juicie-brucie/LEAP_HIP/KiCAD/README.md

# KiCad and LTspice
Well see my other note in the main read me

## KiCad
Schematic mostly done
### ToDo
- Level shifter?
- I need to add the flyback diode back in
- Get a footprint for the HX711 module
- finalize bom
- make the layout

### Issues
Flyback diode
- tired
