juicie-brucie/LEAP_HIP/KiCAD/LTspice_simulation_RevCDR/button_debounce_sim.pdf

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

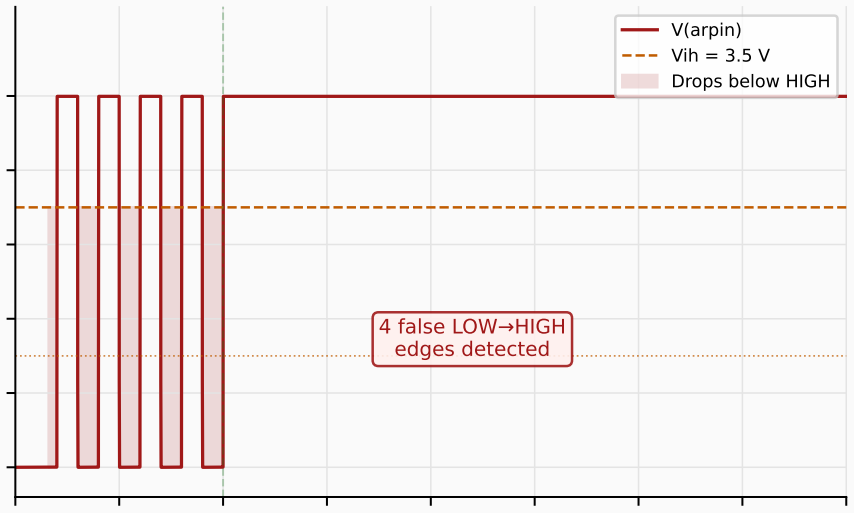
[picture p1: figure]
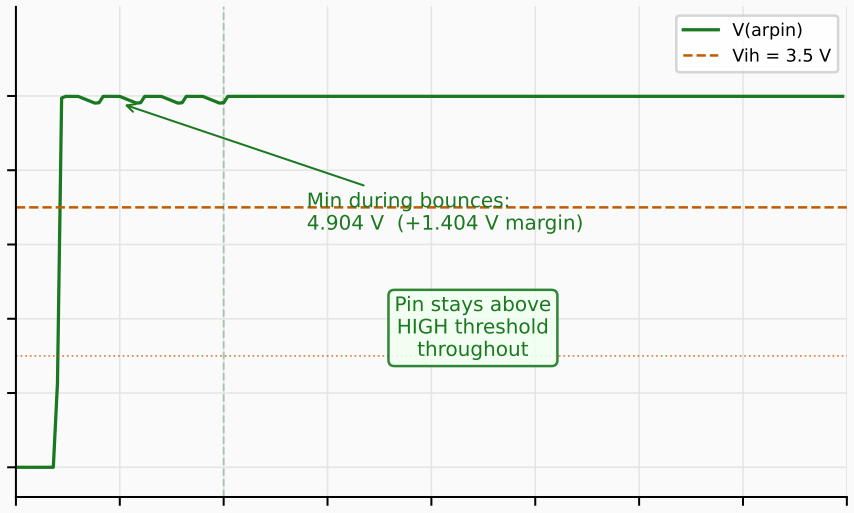
[picture p2: figure]

Parameter | Value | Notes
Filter cap (Rev B) | 100 nF | RC | = 1.0 ms | FAIL: pin drops below 3.5 V on every bounce
Filter cap (fix) | 2.2 µF | RC | = 22 ms | PASS: pin drops only 0.11 V during 0.5 ms bounce
Pulldown resistor | 10 k | Unchanged | sets | with cap; limits current draw
Discharge | (100 nF) | 1.0 ms | 10 k × 100 nF | bounce hold above 3.5 V = only 0.36 | ms
Discharge | (2.2 µF) | 22 ms | 10 k × 2.2 µF | bounce hold above 3.5 V >> 20 ms
Typical bounce duration | 1 | 20 ms | Tactile switches | must exceed worst-case bounce
Voltage drop / bounce | 0.11 V | 2.2 µF: 5 × (1 | e^( 0.5ms/22ms)) | pin stays at 4.89 | V
ATmega328 Vih | 3.5 V | 0.7 × Vcc | Schmitt trigger HIGH threshold at 5 V supply
ATmega328 Vil | 1.5 V | 0.3 × Vcc | Schmitt trigger LOW threshold
Glitches (100 nF) | 4 edges | Arduino sees 4 false button presses per physical press
Glitches (2.2 µF) | 0 edges | No threshold crossing during bounces
Firmware debounce | Required | Read | wait 20 ms | re-read; accept only if still HIGH

NOTE: button_debounce.cir has been updated to use a voltage-controlled switch model. Re-run it in LTspice GUI to get full SPICE confirmation of the 2.2 µF result. The 2.2 µF curve above is computed analytically from the correct RC model.

## Button Debounce Parameters & Fix

BURPG HIP Rev B · LTspice 26.0 · 2026-09-29
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
