juicie-brucie/LEAP_HIP/KiCAD/LTspice_simulation_RevCDR/relay_coil_drive_sim.pdf

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

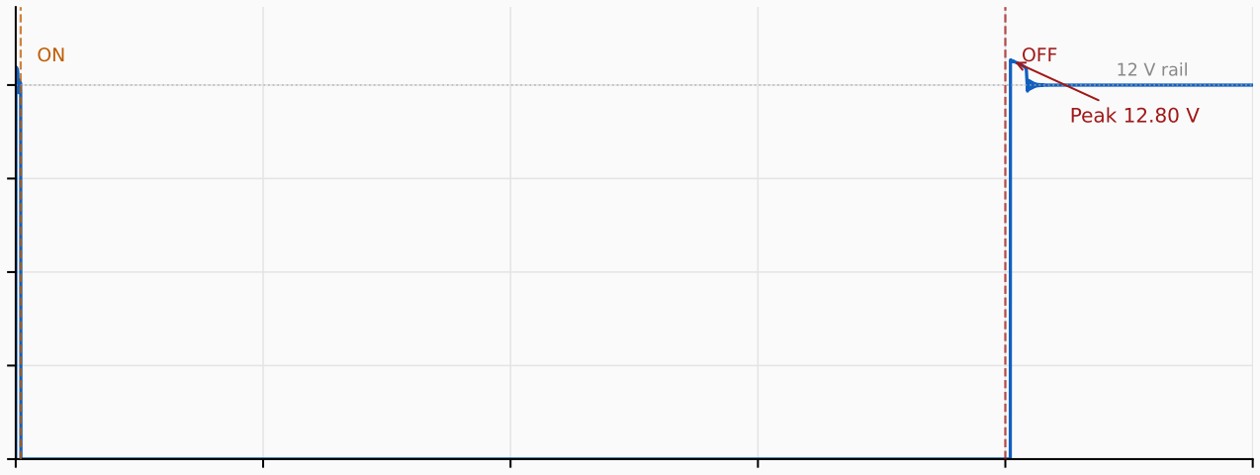
[picture p3: figure]
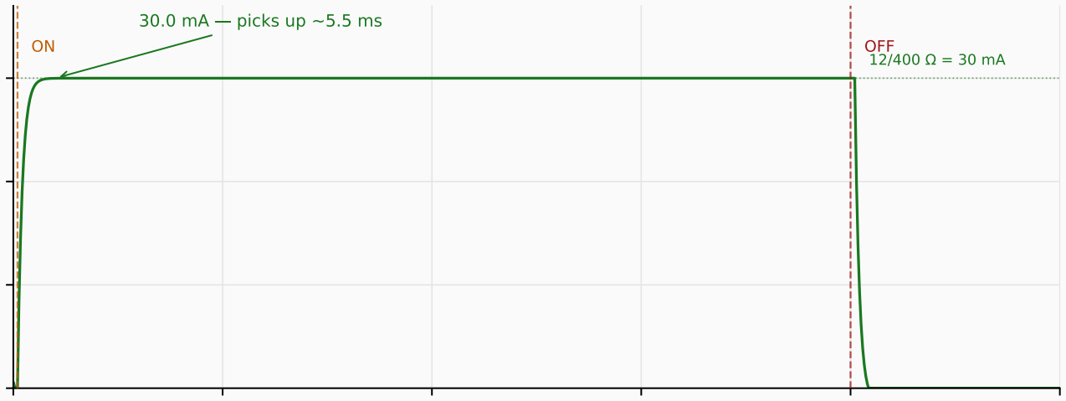
[picture p4: figure]

Parameter | Value | Notes
Flyback spike | 12.80 V | +0.80 V above 12 V rail | smallest spike of both circuits
Steady coil current | 30.0 mA | = 12 V / 400 | exact
Gate voltage | 4.89 V | Same drive as Q1 | fully enhanced
L/R rise time ( ) | 1.1 ms | 440 mH / 400
Relay pick-up time | ~5.5 ms | 5 | contacts close well before igniter circuit becomes live
Coil power | 360 mW | 30 mA × 12 V | SANYOU SRD rated for continuous duty
Coil energy @ 45 s | 16.2 J | 360 mW × 45 s | no thermal concern
MOSFET (Q2) power | <1 mW | 0.03² × 22 m | negligible; consider 2N7002 SOT-23 for BOM

VERDICT: PASS. Both relay coil and MOSFET are within thermal limits at any test duration.

# Q2 Relay Coil Drive Simulation Parameters

BURPG HIP Rev B · LTspice 26.0 · 2026-09-29
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
