juicie-brucie/LEAP_HIP/KiCAD/LTspice_simulation_RevPDR/01_button_debounce_3v3.png

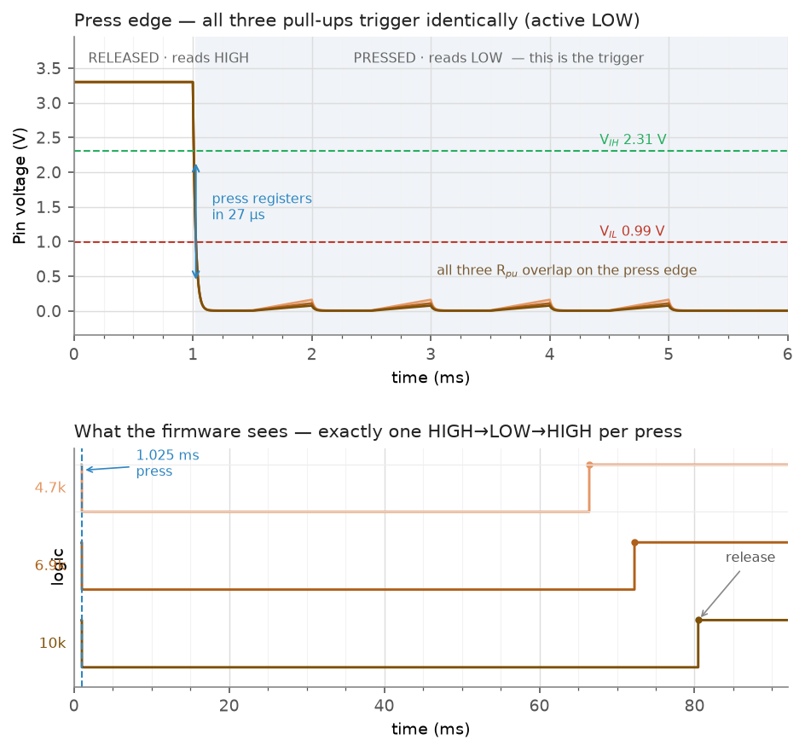
KiCAD/LTspice_simulation_RevPDR/01_button_debounce_3v3.png
