juicie-brucie/LEAP_HIP/KiCAD/LTspice_simulation_RevPDR/02_q1_solenoid.png

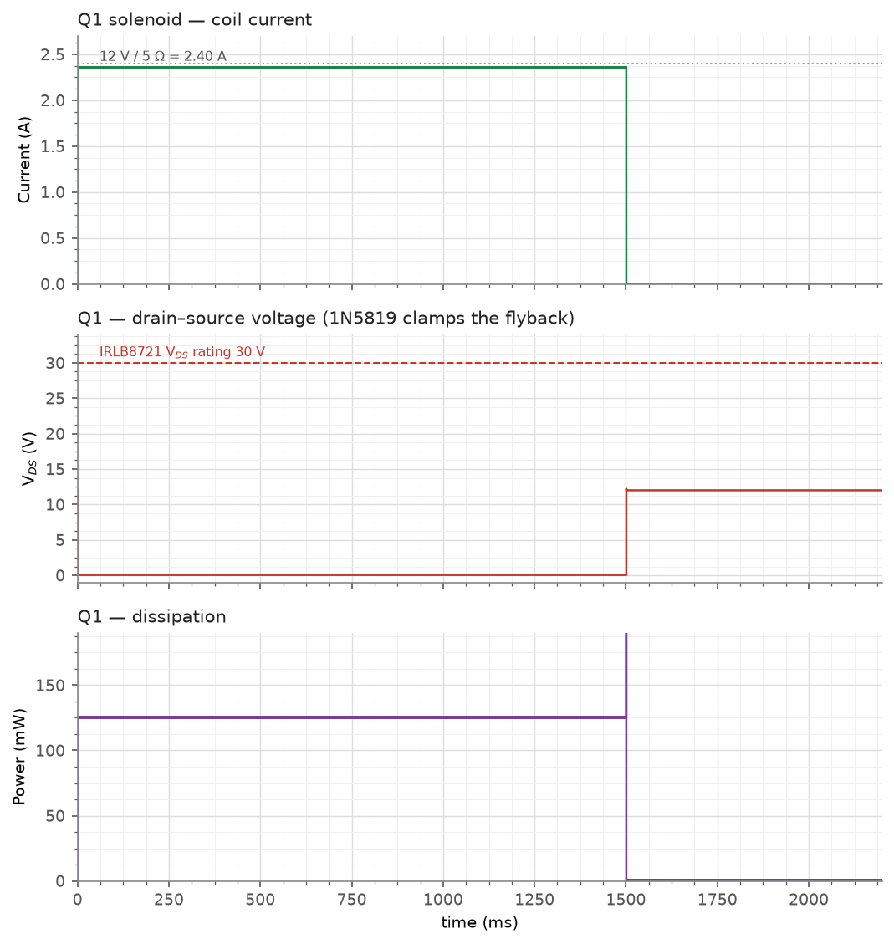
KiCAD/LTspice_simulation_RevPDR/02_q1_solenoid.png
