juicie-brucie/LEAP_HIP/KiCAD/LTspice_simulation_RevPDR/03_q2_igniter.png

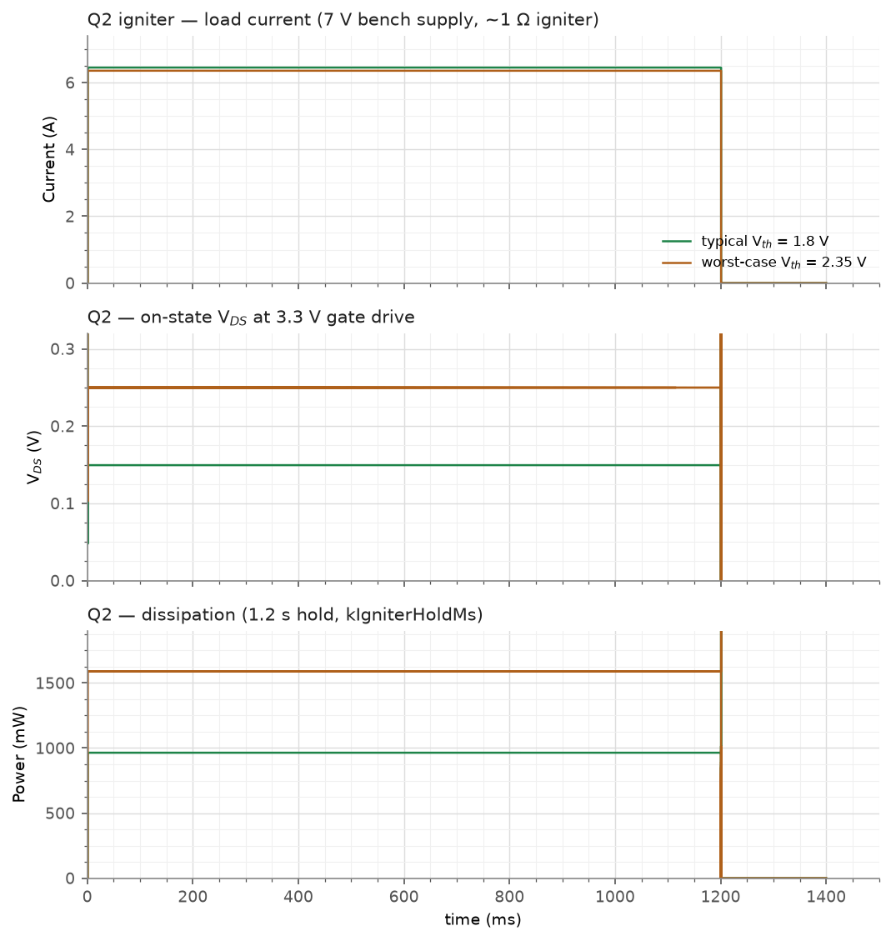
KiCAD/LTspice_simulation_RevPDR/03_q2_igniter.png
