juicie-brucie/LEAP_HIP/KiCAD/LTspice_simulation_RevPDR/04_q2_turnoff_spike.png

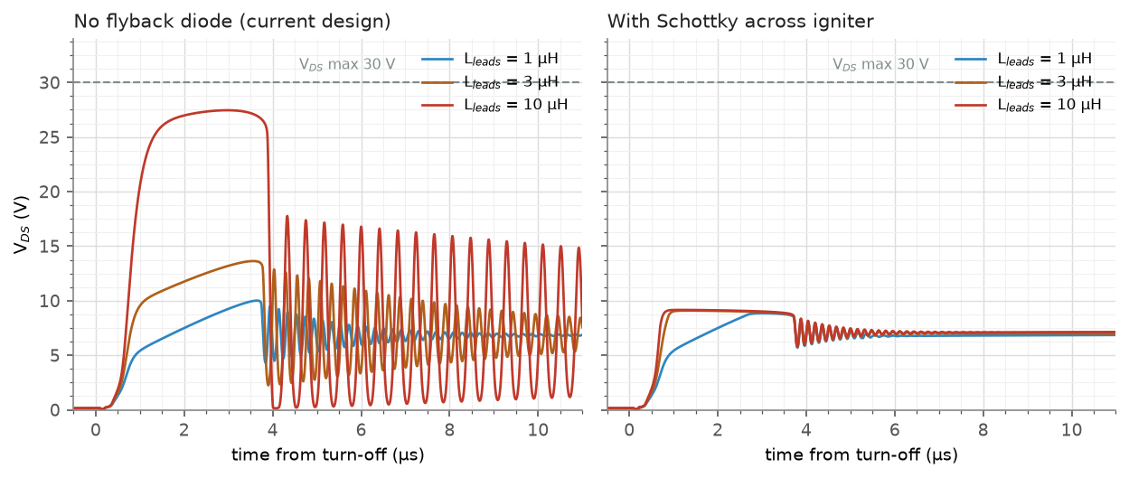
KiCAD/LTspice_simulation_RevPDR/04_q2_turnoff_spike.png
