juicie-brucie/LEAP_HIP/KiCAD/LTspice_simulation_RevPDR/05_rds_vs_vgs.png

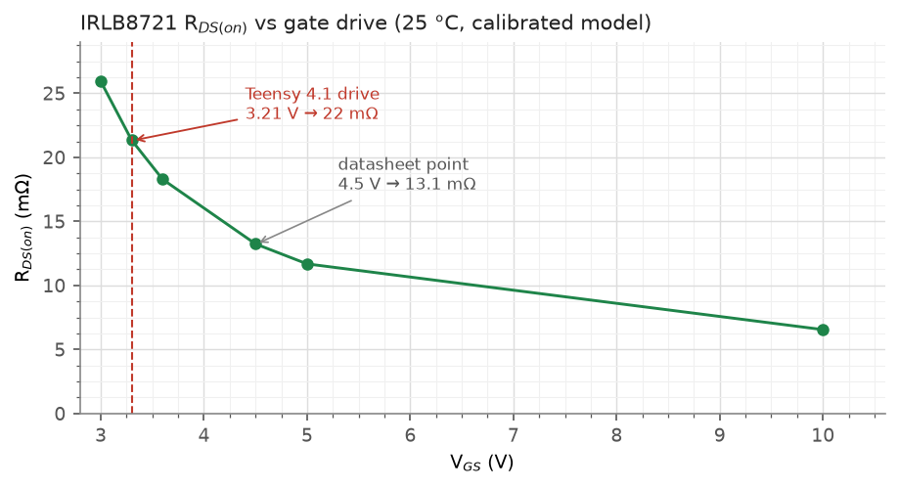
KiCAD/LTspice_simulation_RevPDR/05_rds_vs_vgs.png
