juicie-brucie/LEAP_HIP/KiCAD/BURPG LEAP HIP.kicad_sch

## KiCad design KiCAD/BURPG LEAP HIP.kicad_sch (2026-10-31)

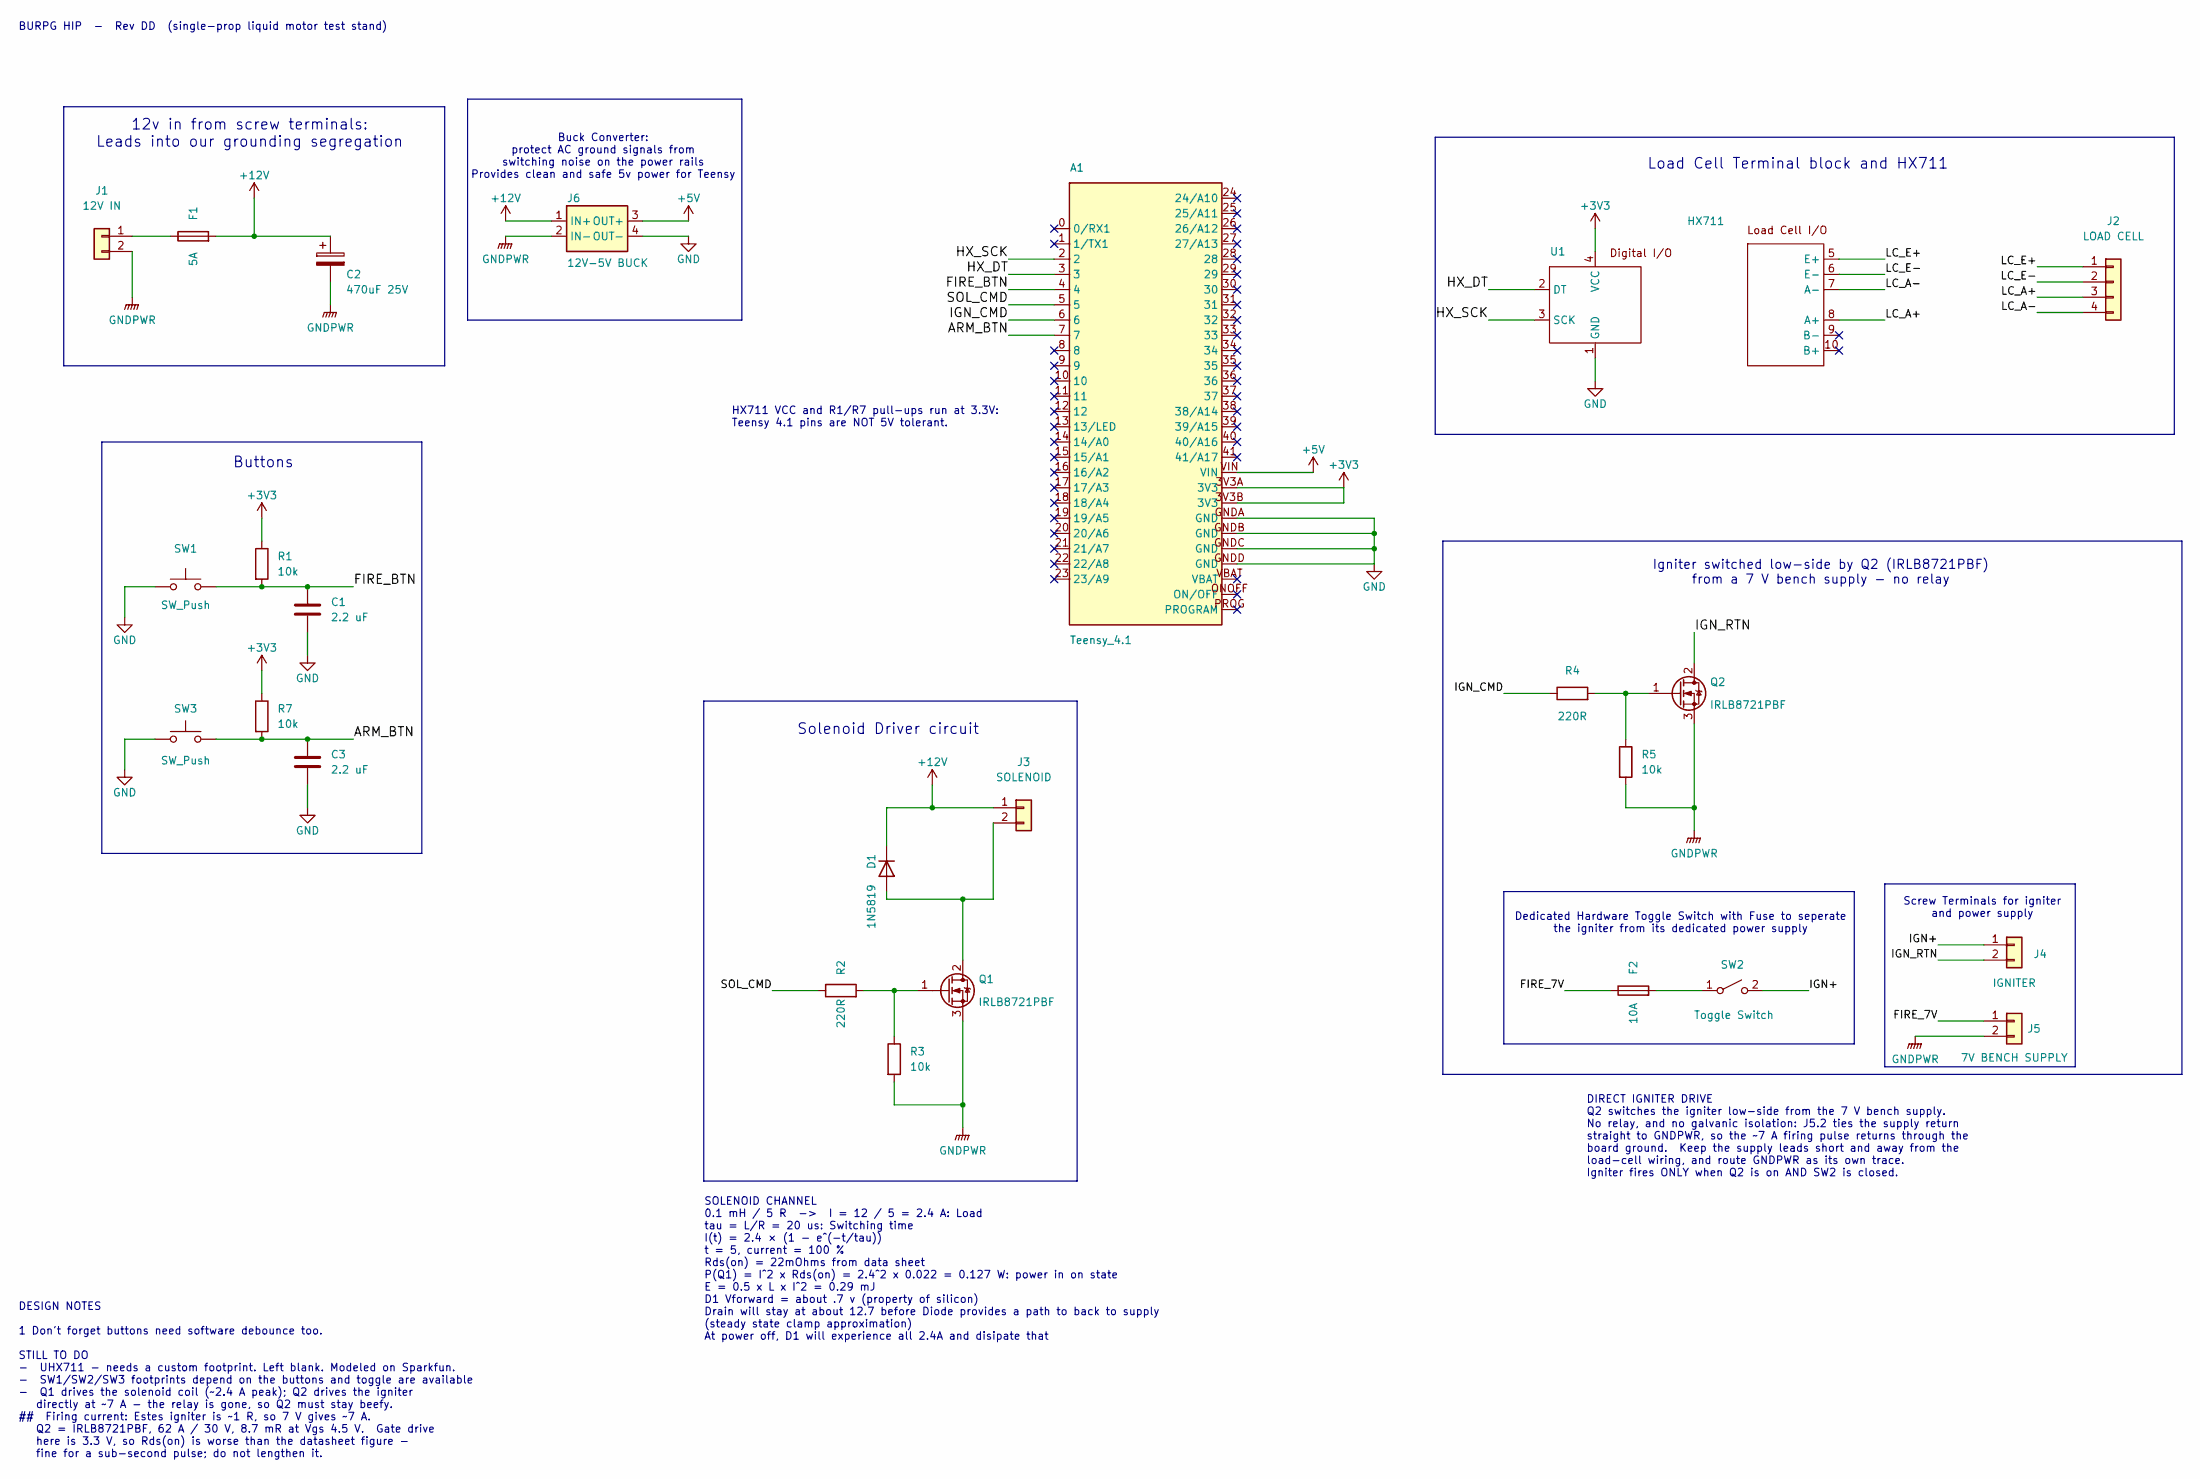
[picture p11: schematic BURPG LEAP HIP.kicad_sch]

Parts:
A1: Teensy_4.1
C1, C3: 2.2 uF; C_Disc_D5.0mm_W2.5mm_P5.00mm
C2: 470uF 25V; CP_Radial_D10.0mm_P5.00mm
D1: 1N5819; D_DO-41_SOD81_P10.16mm_Horizontal
F1: 5A; Fuseholder_Blade_ATO_Littelfuse_Pudenz_2_Pin
F2: 10A; Fuseholder_Blade_ATO_Littelfuse_Pudenz_2_Pin
J1: 12V IN; TerminalBlock_MaiXu_MX126-5.0-02P_1x02_P5.00mm
J2: LOAD CELL; TerminalBlock_MaiXu_MX126-5.0-04P_1x04_P5.00mm
J3: SOLENOID; TerminalBlock_MaiXu_MX126-5.0-02P_1x02_P5.00mm
J4: IGNITER; TerminalBlock_MaiXu_MX126-5.0-02P_1x02_P5.00mm
J5: 7V BENCH SUPPLY; TerminalBlock_MaiXu_MX126-5.0-02P_1x02_P5.00mm
J6: 12V-5V BUCK
Q1, Q2: IRLB8721PBF; TO-220-3_Vertical
R1, R3, R5, R7: 10k; R_Axial_DIN0207_L6.3mm_D2.5mm_P10.16mm_Horizontal
R2, R4: 220R; R_Axial_DIN0207_L6.3mm_D2.5mm_P10.16mm_Horizontal
SW1, SW3: SW_Push
SW2: Toggle Switch
U1: HX711

Connections:
+3V3: A1.3V3A (3V3), A1.3V3B (3V3), R1.1, R7.1, U1.4 (VCC)
+5V: A1.VIN, J6.3 (OUT+)
+12V: C2.1, D1.1 (K), F1.2, J3.1, J6.1 (IN+)
ARM_BTN: A1.7, C3.1, R7.2, SW3.2
FIRE_7V: F2.1, J5.1
FIRE_BTN: A1.4, C1.1, R1.2, SW1.2
GND: A1.GNDA (GND), A1.GNDB (GND), A1.GNDC (GND), A1.GNDD (GND), C1.2, C3.2, J6.4 (OUT-), SW1.1, SW3.1, U1.1 (GND)
GNDPWR: C2.2, J1.2, J5.2, J6.2 (IN-), Q1.3 (S), Q2.3 (S), R3.2, R5.2
HX_DT: A1.3, U1.2 (DT)
HX_SCK: A1.2, U1.3 (SCK)
IGN+: J4.1, SW2.2 (B)
IGN_CMD: A1.6, R4.1
IGN_RTN: J4.2, Q2.2 (D)
LC_A+: J2.3, U1.8 (A+)
LC_A-: J2.4, U1.7 (A-)
LC_E+: J2.1, U1.5 (E+)
LC_E-: J2.2, U1.6 (E-)
unnamed: D1.2 (A), J3.2, Q1.2 (D)
unnamed: F1.1, J1.1
unnamed: F2.2, SW2.1 (A)
unnamed: Q1.1 (G), R2.2, R3.1
unnamed: Q2.1 (G), R4.2, R5.1
SOL_CMD: A1.5, R2.1

Notes on the sheet:
DIRECT IGNITER DRIVE Q2 switches the igniter low-side from the 7 V bench supply. No relay, and no galvanic isolation: J5.2 ties the supply return straight to GNDPWR, so the ~7 A firing pulse returns through the board ground. Keep the supply leads short and away from the load-cell wiring, and route 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
HX711 VCC and R1/R7 pull-ups run at 3.3V: Teensy 4.1 pins are NOT 5V tolerant.
DESIGN NOTES 1 Don't forget buttons need software debounce too. STILL TO DO - UHX711 - needs a custom footprint. Left blank. Modeled on Sparkfun. - SW1/SW2/SW3 footprints depend on the buttons and toggle are available - Q1 drives the solenoid coil (~2.4 A peak); Q2 drives the igniter directly at ~7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
BURPG HIP - Rev DD (single-prop liquid motor test stand)
Dedicated Hardware Toggle Switch with Fuse to seperate the igniter from its dedicated power supply
12v in from screw terminals: Leads into our grounding segregation
Screw Terminals for igniter and power supply
SOLENOID CHANNEL 0.1 mH / 5 R -> I = 12 / 5 = 2.4 A: Load tau = L/R = 20 us: Switching time I(t) = 2.4 × (1 − e^(−t/tau)) t = 5, current = 100 % Rds(on) = 22mOhms from data sheet P(Q1) = I^2 x Rds(on) = 2.4^2 x 0.022 = 0.127 W: power in on state E = 0.5 x L x I^2 = 0.29 mJ D1 Vforward = about .7 v 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
Igniter switched low-side by Q2 (IRLB8721PBF) from a 7 V bench supply - no relay
Solenoid Driver circuit
Buck Converter: protect AC ground signals from switching noise on the power rails Provides clean and safe 5v power for Teensy
Buttons
Load Cell Terminal block and HX711
