juicie-brucie/LEAP_HIP/(commit log)

2026-10-31 PDR Update
    Bruce and deepseek pull an all nighter
    [BURPG LEAP HIP.kicad_sch]
2026-10-31 Update README with KiCad and LTspice notes
    Added notes about KiCad and LTspice installation.
2026-10-31 Create README.md for KiCad project
    Added initial README content for KiCad project.
2026-10-31 Fix formatting in KiCAD README
    Truly some next level syntax from me going on here, and just committing without even looking at the preview like a baller
